agonzalesx86/Microquadcopter/Software/IMU Register Notes.rtf

Setting up the low pass and high pass filters:

LAB 6 DIRECTIONS:
- low pass the accelerometer and high pass the gyroscopes
- configure the two registers to set up filtering on the accelerometer outputs. (ODR and DF cutoff frequencies)
- also enable (high-resolution mode).

From the Diagram: (Figure 8)
(Accelerometer)
HR 1
FDS 0

(Gyroscope)
HP_EN 1

ACCELEROMETER REGISTER CONFIGURATION
===========================================================================================
CTRL_REG6_XL register: [WRITE = PD]

Note: The ODR_XL register setting is only used when in accelerometer only mode.

Description Value
————————————————————————————————
FS_XL 00 (Corresponds to 2g)
BW_SCAL_ODR 105 Hz

SET TO: 000 00 1 11 07*
DEFAULT: 11000000 (952 HZ)
===========================================================================================
CTRL_REG7_XL register: [WRITE TO THIS FOR HR ENABLE AND DF CONFIG]

SET TO: 1 DCF1 DCF0 00 1 0 0

1 11 00 1 0 0 E4*
1 00 00 1 0 0 84
1 01 00 1 0 0 A4
1 11 00 1 0 1 E5

DCF LP Cutoff
00 ODR/50
01 ODR/100
10 ODR/9
11 ODR/400

GYROSCOPE REGISTER CONFIGURATION
===========================================================================================
CTRL_REG1_G (10h) [USE TO SET THE ODR]

ODR_G2 ODR_G1 ODR_G0 FS_G1 FS_G0 0 BW_G BW_G0

SET TO: 100 01 0 10 8A*
011 00 0 00 60
ODR: 238 Hz
Cutoff: 76 Hz (LPF1)
Cutoff: 63 Hz (LPF2)

===========================================================================================
CTRL_REG3_G (12h)

SET TO: 0 1 0 0 0010 (4.0 Hz) 42
0 1 0 0 0101 (0.5 Hz) 45
0 1 0 0 1000 (0.05Hz)
0 1 0 0 0000 (15Hz) 40*
Cutoff: 4 Hz
