agonzalesx86/Microquadcopter/Schematic & Hardware/quadcopter.brd

## EAGLE design Schematic & Hardware/quadcopter.brd (2018-06-13)

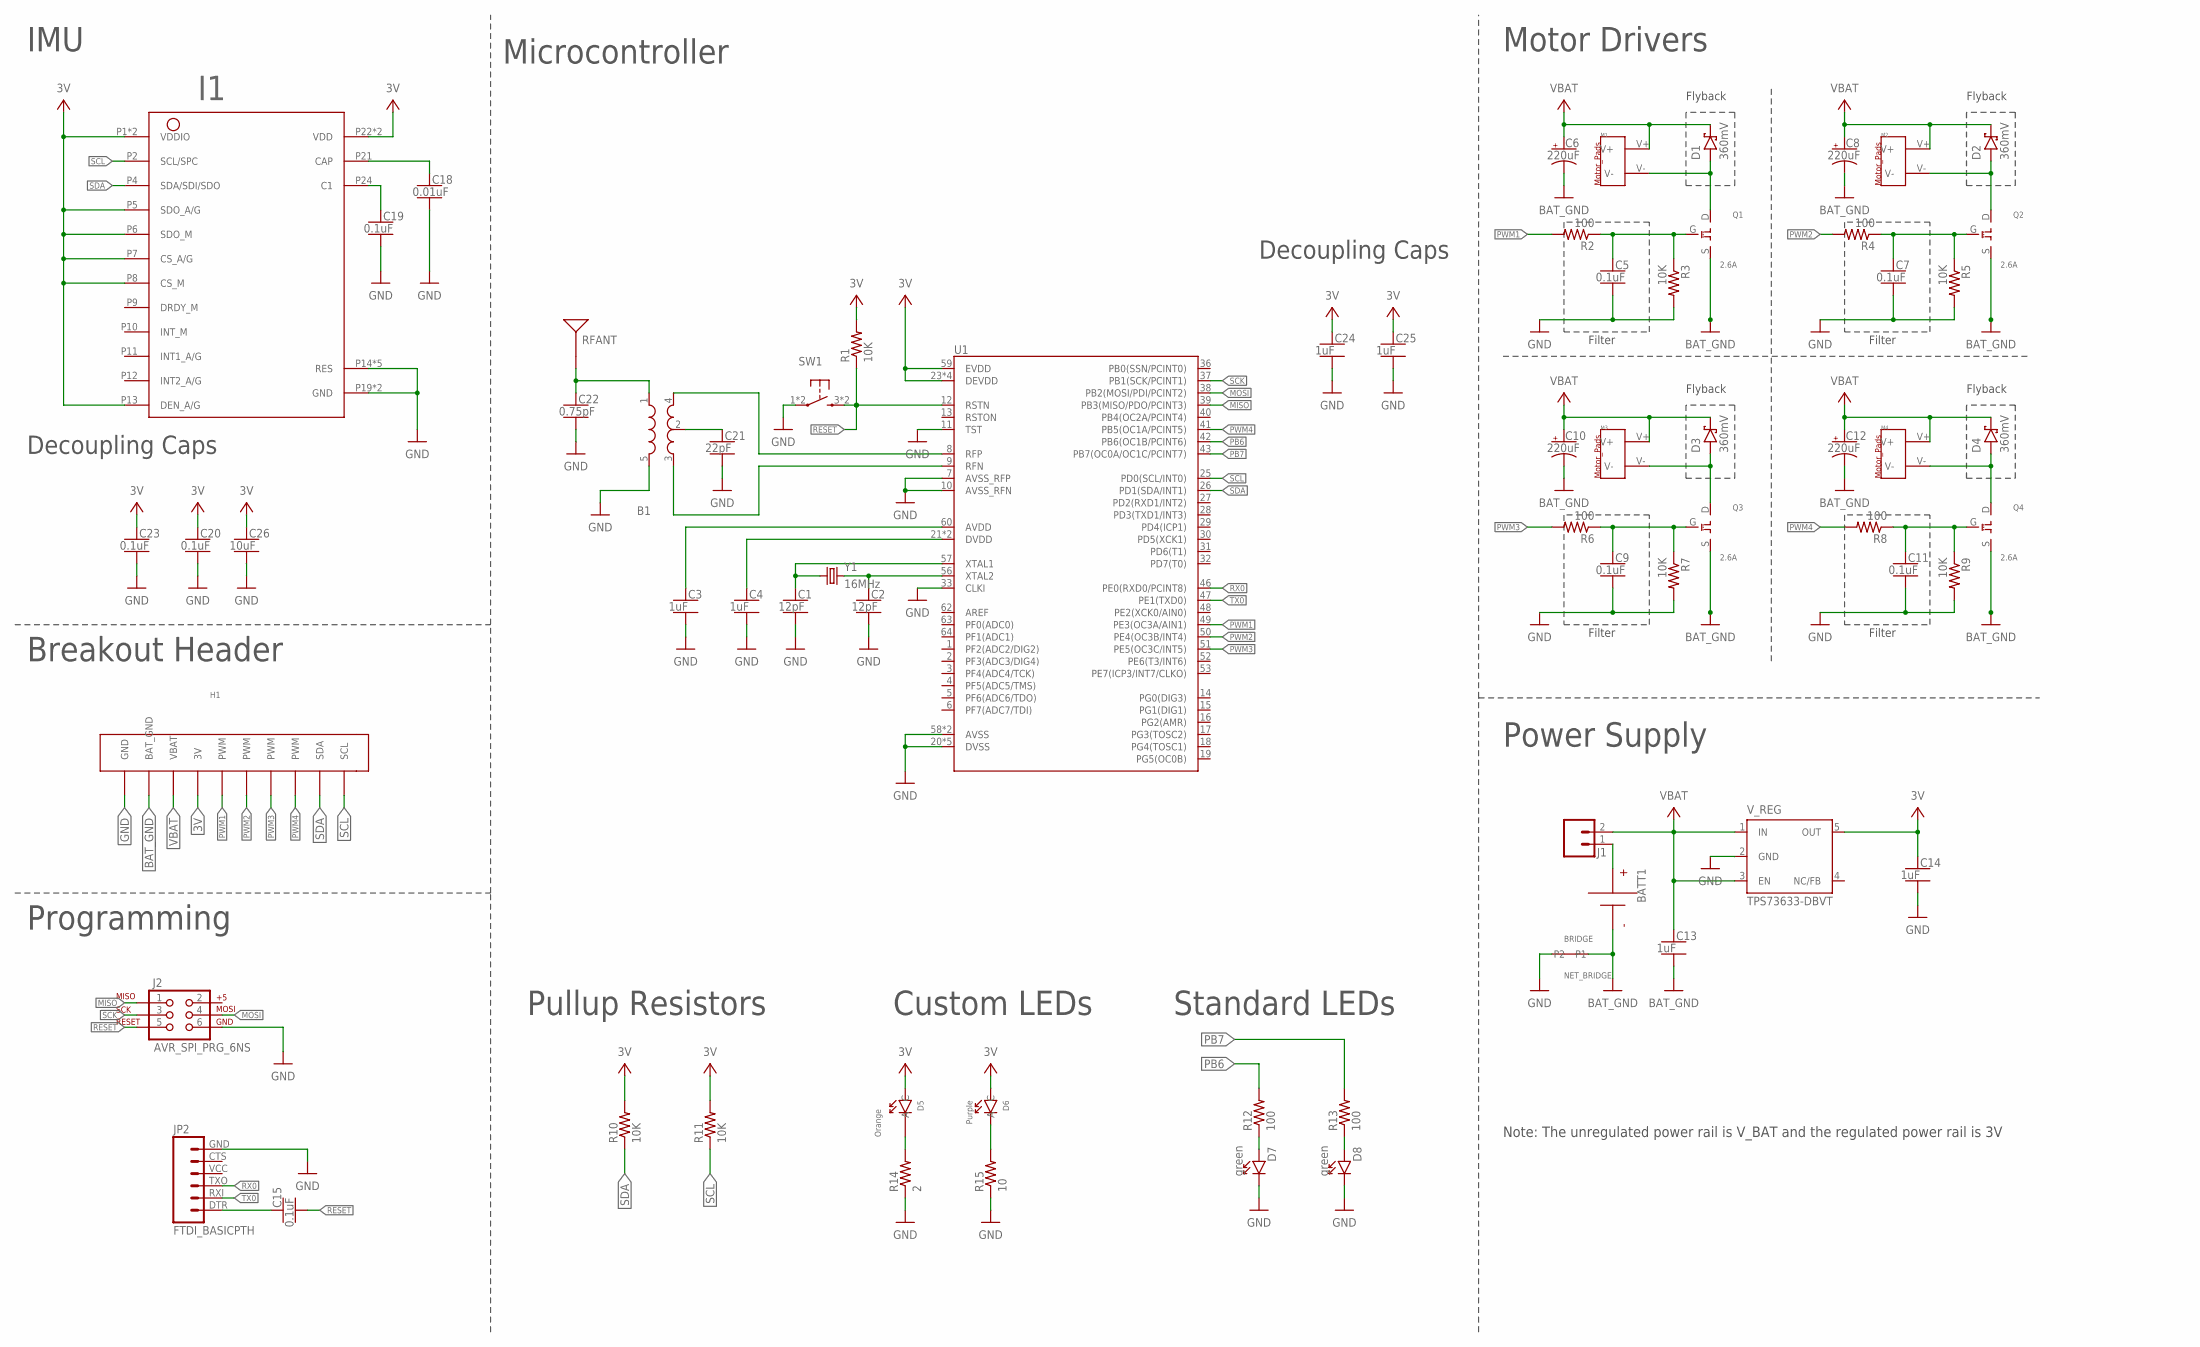
[picture p1: schematic quadcopter.sch]

Parts:
B1: BALUN0805; BALUN
BATT1: BATTERY-HUBSAN-W/HOLDER; BATTERY-W/HOLDER-380MAH-HUBSAN
BRIDGE: NET_BRIDGE
C1, C2: 12pF; CAPC2012X140_HS
C3, C4, C13, C14, C24, C25: 1uF; CAPC2012X140_HS
C5, C7, C9, C11, C15, C19, C20, C23: 0.1uF; CAPC2012X140_HS
C6, C8, C10, C12: 220uF; CAPMP7343X310_HS
C18: 0.01uF; CAPC2012X140_HS
C21: 22pF; CAPC2012X140_HS
C22: 0.75pF; CAPC2012X140_HS
C26: 10uF; CAPC2012X140_HS
D1, D2, D3, D4: 360mV; SOD3716X135_HS
D5: Orange; LED_ORANGE
D6: Purple; LED_PURPLE
D7, D8: green; LEDSC125X200X120-2_HS
H1: BREAKOUT_HEADER
I1: IMU_LSM9DS1TR
J1: MALE_HEADER_2POS-2X1-0.1IN; MALE_HEADER_2X1_0.1IN
J2: AVR_SPI_PRG_6NS; 2X3-NS
JP2: FTDI_BASICPTH; FTDI_BASIC
M1, M2, M3, M4: MOTOR_PADS
Q1, Q2, Q3, Q4: 2.6A; MOSFET_N-CHANNEL
R1, R3, R5, R7, R9, R10, R11: 10K; RESC2012X60_HS
R2, R4, R6, R8, R12, R13: 100; RESC2012X60_HS
R14: 2; RESISTOR_0805
R15: 10; RESISTOR_0805
RFANT: ANTENNA2SMD5; ANTENNA-CHIP5
SW1: PUSHBUTTON_SMD-VERTICAL-1; TE_FSM8JSMA_HS
U1: ATMEGA128RFA1; QFN-64
V_REG: TPS73633-DBVT; SOT23-DBV
Y1: 16MHz; CRYSTAL-SMD-5X3

Connections:
3V: C14.1, C20.1, C23.1, C24.1, C25.1, C26.1, D5.A, D6.A, H1.1 (3V), I1.P1 (VDDIO), I1.P3 (VDDIO), I1.P5 (SDO_A/G), I1.P6 (SDO_M), I1.P7 (CS_A/G), I1.P8 (CS_M), I1.P13 (DEN_A/G), I1.P22 (VDD), I1.P23 (VDD), R1.2, R10.2, R11.2, U1.23 (DEVDD), U1.34 (DEVDD), U1.44 (DEVDD), U1.54 (DEVDD), U1.59 (EVDD), V_REG.5 (OUT)
BAT_GND: BATT1.- (N), BRIDGE.P2, C6.2 (-), C8.2 (-), C10.2 (-), C12.2 (-), C13.2, H1.2 (BAT_GND), Q1.S, Q2.S, Q3.S, Q4.S
GND: B1.5 (GND), BRIDGE.P1, C1.2, C2.2, C3.2, C4.2, C5.2, C7.2, C9.2, C11.2, C14.2, C18.2, C19.2, C20.2, C21.2, C22.2, C23.2, C24.2, C25.2, C26.2, D7.C, D8.C, H1.3 (GND), I1.P14 (RES), I1.P15 (RES), I1.P16 (RES), I1.P17 (RES), I1.P18 (RES), I1.P19 (GND), I1.P20 (GND), J2.6, JP2.GND (6), R3.2, R5.2, R7.2, R9.2, R14.IN (1), R15.IN (1), SW1.1, SW1.2 (1), U1.7 (AVSS_RFP), U1.10 (AVSS_RFN), U1.11 (TST), U1.20 (DVSS), U1.24 (DVSS), U1.33 (CLKI), U1.35 (DVSS), U1.45 (DVSS), U1.55 (DVSS), U1.58 (AVSS), U1.61 (AVSS), V_REG.2 (GND)
MISO: J2.1, U1.39 (PB3(MISO/PDO/PCINT3))
MOSI: J2.4, U1.38 (PB2(MOSI/PDI/PCINT2))
unnamed: D6.C, R15.OUT (2)
unnamed: B1.4 (OUT1), U1.8 (RFP)
unnamed: B1.3 (OUT2), U1.9 (RFN)
unnamed: C4.1, U1.21 (DVDD), U1.22 (DVDD)
unnamed: C2.1, U1.56 (XTAL2), Y1.3 (2)
unnamed: C3.1, U1.60 (AVDD)
unnamed: C1.1, U1.57 (XTAL1), Y1.1
unnamed: D1.A, M1.V-, Q1.D
unnamed: D5.C, R14.OUT (2)
unnamed: C7.1, Q2.G, R4.1, R5.1
unnamed: D2.A, M2.V-, Q2.D
unnamed: C9.1, Q3.G, R6.1, R7.1
unnamed: C5.1, Q1.G, R2.1, R3.1
unnamed: D3.A, M3.V-, Q3.D
unnamed: C11.1, Q4.G, R8.1, R9.1
unnamed: D7.A, R12.1
unnamed: BATT1.+, J1.1
unnamed: B1.2 (GND), C21.1
unnamed: D4.A, M4.V-, Q4.D
unnamed: C18.1, I1.P21 (CAP)
unnamed: C19.1, I1.P24 (C1)
unnamed: B1.1 (IN), C22.1, RFANT.FEED
unnamed: C15.1, JP2.DTR (1)
unnamed: D8.A, R13.1
PB6: R12.2, U1.42 (PB6(OC1B/PCINT6))
PB7: R13.2, U1.43 (PB7(OC0A/OC1C/PCINT7))
PWM1: H1.4 (PWM), R2.2, U1.49 (PE3(OC3A/AIN1))
PWM2: H1.5 (PWM), R4.2, U1.50 (PE4(OC3B/INT4))
PWM3: H1.6 (PWM), R6.2, U1.51 (PE5(OC3C/INT5))
PWM4: H1.7 (PWM), R8.2, U1.41 (PB5(OC1A/PCINT5))
RESET: C15.2, J2.5, R1.1, SW1.3 (2), SW1.4 (2), U1.12 (RSTN)
RX0: JP2.TXO (3), U1.46 (PE0(RXD0/PCINT8))
SCK: J2.3, U1.37 (PB1(SCK/PCINT1))
SCL: H1.8 (SCL), I1.P2 (SCL/SPC), R11.1, U1.25 (PD0(SCL/INT0))
SDA: H1.9 (SDA), I1.P4 (SDA/SDI/SDO), R10.1, U1.26 (PD1(SDA/INT1))
TX0: JP2.RXI (2), U1.47 (PE1(TXD0))
VBAT: C6.1 (+), C8.1 (+), C10.1 (+), C12.1 (+), C13.1, D1.C, D2.C, D3.C, D4.C, H1.10 (VBAT), J1.2, M1.V+, M2.V+, M3.V+, M4.V+, V_REG.1 (IN), V_REG.3 (EN)

Notes on the sheet:
Microcontroller
Motor Drivers
Power Supply
Breakout Header
IMU
Programming
Filter
Flyback
Note: The unregulated power rail is V_BAT and the regulated power rail is 3V
Pullup Resistors
Custom LEDs
Standard LEDs
Decoupling Caps

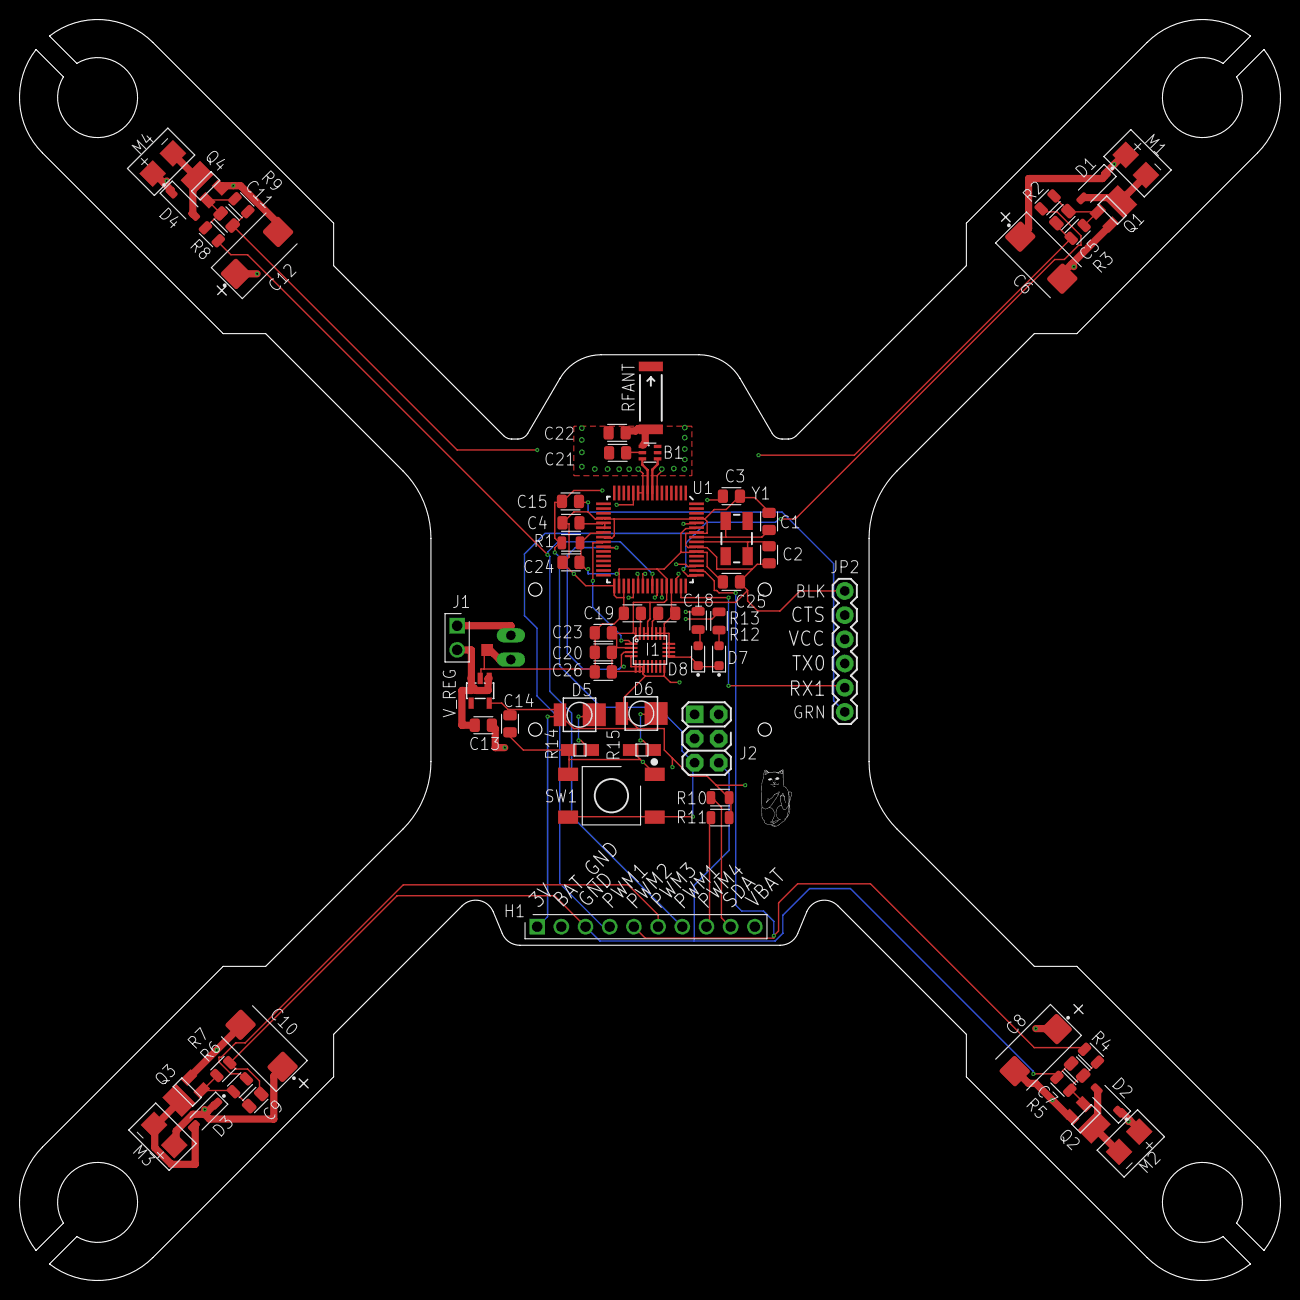
[picture p2: board quadcopter.brd from above]

Board: 4 copper layers, 132.4 x 132.4 mm, 69 parts (1 on the bottom side), 42 nets.

Other parts of the board:
U$3: UCSD_LOGO
